vthinh-la/smart-solar-cloud-speaker-iot/docs/contest/LENH_DIEU_KHIEN_LOA_CLOUD.docx

Các lệnh MQTT điều khiển ESP32-Radio

1. Gửi lệnh MQTT

Lệnh điều khiển được publish vào topic:

prefix/command

Ví dụ:

mosquitto_pub -h broker.hivemq.com -t espradio/command -m "volume=80"

2. Các lệnh điều khiển

Lệnh | Chức năng
preset=12 | Chọn preset 12 để phát
preset_00=<mp3 stream> | Đặt preset 00 thành một URL stream
volume=95 | Đặt âm lượng ở mức 95%
upvolume=2 | Tăng âm lượng thêm 2%
downvolume=2 | Giảm âm lượng đi 2%
toneha=<0..15> | Điều chỉnh độ lớn của treble
tonehf=<0..15> | Điều chỉnh tần số treble
tonela=<0..15> | Điều chỉnh độ lớn của bass
tonelf=<0..15> | Điều chỉnh tần số bass
station=<mp3 stream> | Chuyển sang stream MP3 mới
station=<URL>.mp3 | Phát một file MP3 từ URL
station=<URL>.m3u | Phát một playlist M3U
mute | Bật tắt chế độ mute
unmute | Hủy chế độ mute
wifi_00=SSID/PASSWORD | Cài đặt WiFi
mqttbroker=mybroker.com | Đặt MQTT broker mới
mqttuser=myuser | Đặt tên người dùng MQTT
mqttpasswd=mypassword | Đặt mật khẩu MQTT
sleep | Đưa thiết bị vào chế độ ngủ sâu
status | Kiểm tra trạng thái hiện tại
debug=1 | Bật chế độ debug
reset | Khởi động lại ESP32

3. Các topic ESP32-Radio publish lên MQTT

Topic | Nội dung publish
prefix/ip | Địa chỉ IP của thiết bị
prefix/icy/name | Tên kênh radio đang phát
prefix/icy/streamtitle | Tiêu đề stream
prefix/nowplaying | Bài hát đang phát
prefix/preset | Preset hiện tại
prefix/volume | Mức âm lượng hiện tại
prefix/playing | 1 nếu đang phát, 0 nếu dừng
