vthinh-la/smart-solar-cloud-speaker-iot/docs/contest/Noi_Dung_San_Pham_Du_Thi.docx

Tên sản phẩm dự thi: Hệ Thống Loa Cloud IOT

1.Tại Sao EM chọn dự án này ?

Em chọn dự án “Hệ thống loa Cloud IoT” vì đây là một giải pháp tích hợp các công nghệ đơn giản nhưng hiệu quả để xây dựng một hệ thống loa phát thanh hoạt động độc lập. Hệ thống sử dụng mạng 4G để truyền tải âm thanh, giúp khắc phục những hạn chế của các hệ thống truyền thống như sóng FM hay hệ thống kéo dây, vốn yêu cầu hạ tầng phức tạp và dễ gặp phải các vấn đề về phạm vi phủ sóng hoặc thiệt hại do thời tiết. Việc tích hợp năng lượng mặt trời để sạc pin và pin lưu trữ giúp hệ thống duy trì hoạt động liên tục mà không cần nguồn điện lưới, điều này đặc biệt hữu ích ở các khu vực công cộng hoặc ngoài trời. Đặc biệt, hệ thống còn có cảm biến ánh sáng để tự động bật đèn khi trời tối, tăng cường tính tiện dụng và tiết kiệm năng lượng. Hệ thống có thể được triển khai tại các khu vực công cộng, như điểm trường, trạm y tế hay khu dân cư, giúp truyền tải thông tin một cách linh hoạt và hiệu quả mà không phụ thuộc vào các hạ tầng truyền thống.

Ứng Dụng Tại:

Khu vực công cộng: Hệ thống có thể được triển khai tại các điểm trường, trạm y tế, khu dân cư, hay các địa điểm công cộng khác để truyền tải thông tin, thông báo khẩn cấp hoặc tuyên truyền. Khả năng sử dụng mạng 4G và năng lượng mặt trời giúp hệ thống hoạt động độc lập, không phụ thuộc vào cơ sở hạ tầng điện và mạng lưới có sẵn.

Khu vực ngoài trời và vùng hẻo lánh: Với tính năng sử dụng năng lượng mặt trời và pin lưu trữ, hệ thống phù hợp cho các khu vực không có nguồn điện ổn định hoặc các khu vực không dễ dàng tiếp cận. Hệ thống này có thể sử dụng cho các trạm phát thanh ngoài trời, điểm du lịch hoặc khu vực nông thôn, nơi cần truyền tải thông tin mà không cần phải kéo dây điện hay sử dụng sóng FM truyền thống.

Hệ thống thông báo khẩn cấp: Trong các tình huống khẩn cấp như thiên tai hoặc thảm họa, hệ thống có thể được sử dụng để phát thông báo đến cộng đồng, nhờ khả năng hoạt động độc lập và truyền tải thông tin từ xa, ngay cả khi cơ sở hạ tầng khác không hoạt động.

Các sự kiện ngoài trời: Hệ thống có thể được dùng cho các sự kiện ngoài trời như lễ hội, hội thảo, hoặc các hoạt động cộng đồng, giúp phát thanh thông báo hoặc âm nhạc mà không cần quá nhiều thiết bị phức tạp.

Ứng dụng trong các công trình xây dựng: Hệ thống có thể được sử dụng trong các công trình xây dựng hoặc khu vực công nghiệp, giúp truyền tải thông tin nội bộ, cảnh báo hoặc hướng dẫn an toàn cho công nhân mà không phải kéo dây điện hoặc sử dụng các thiết bị truyền thống.

Cách Lắp Đặt:

1. Các khu vực công cộng

- Ví dụ ứng dụng:
  - Điểm trường học, trạm y tế, khu dân cư.
  - Công viên, quảng trường, khu vui chơi.
  - Các khu vực tổ chức sự kiện ngoài trời, như lễ hội, hội thảo cộng đồng.
- Cách lắp đặt:
  - Lắp đặt loa ở vị trí cao, dễ tiếp cận và có tầm phát sóng rộng, tránh vật cản như tòa nhà cao.
  - Tấm pin mặt trời được gắn lên mái nhà hoặc cột, nơi có ánh sáng mặt trời trực tiếp và không bị che khuất.
  - Đặt bộ sạc và pin lưu trữ ở khu vực kín đáo để bảo vệ khỏi mưa gió, nhưng vẫn đảm bảo thông gió.
  - Cảm biến ánh sáng được gắn tại nơi có thể phát hiện ánh sáng tự nhiên để điều khiển bật đèn khi trời tối.

2. Khu vực ngoài trời, nông thôn, miền núi

- Ví dụ ứng dụng:
  - Các thôn, bản chưa có điện hoặc hạ tầng mạng ổn định.
  - Trạm phát thanh thông tin cho cộng đồng tại khu vực nông thôn, nơi không có cơ sở hạ tầng mạng.
- Cách lắp đặt:
  - Chọn vị trí có tín hiệu 4G mạnh để đảm bảo kết nối ổn định (điều này rất quan trọng khi dùng 4G để truyền tải âm thanh).
  - Cột loa và tấm pin mặt trời có thể được dựng trên các cột hoặc mái nhà, cách xa các nguồn phát tín hiệu nhiễu (chẳng hạn như các khu vực nhiều tòa nhà hay cây cối).
  - Dây điện và kết nối: Dùng cáp dài để kết nối giữa các thiết bị trong hệ thống, đảm bảo an toàn và chịu được điều kiện thời tiết ngoài trời.

3. Hệ thống thông báo khẩn cấp

- Ví dụ ứng dụng:
  - Các khu vực dễ bị thiên tai như vùng ven biển, khu vực dễ xảy ra động đất, cháy nổ.
- Cách lắp đặt:
  - Lắp đặt ở các khu vực dễ bị tác động: Chẳng hạn như trạm cứu hộ, tòa nhà công cộng, khu vực cư trú gần khu vực nguy hiểm.
  - Dùng pin và tấm pin mặt trời để hệ thống hoạt động liên tục mà không cần nguồn điện chính.
  - Tạo mạng lưới kết nối các loa để có thể phát âm thanh đồng bộ, truyền tải thông báo khẩn cấp trong thời gian thực.

4. Các công trình xây dựng

- Ví dụ ứng dụng:
  - Các công trường xây dựng, khu vực thi công hoặc các khu công nghiệp.
- Cách lắp đặt:
  - Đặt loa ở các khu vực dễ nghe: Chọn vị trí lắp đặt loa sao cho âm thanh được phát tán rộng rãi đến các khu vực thi công hoặc xung quanh công trường.
  - Đặt tấm pin mặt trời trên các giàn giáo hoặc mái công trình để dễ dàng tiếp xúc với ánh sáng mặt trời.
  - Hệ thống hoạt động bằng pin và năng lượng mặt trời giúp công nhân nhận được thông tin cảnh báo hoặc thông báo về an toàn lao động.

Hệ thống loa Cloud IoT chủ yếu sẽ được sử dụng bởi các đối tượng sau:

1. Chính quyền địa phương và các cơ quan công cộng

- Ứng dụng: Truyền tải thông tin, thông báo khẩn cấp, tuyên truyền, thông báo về các chính sách, sự kiện hoặc thông tin cộng đồng đến người dân trong các khu vực công cộng như trường học, trạm y tế, khu dân cư.
- Lý do sử dụng: Các cơ quan này cần hệ thống có thể hoạt động độc lập, tiết kiệm chi phí và không phụ thuộc vào hạ tầng mạng lưới điện hay Wi-Fi, đặc biệt là ở các khu vực hẻo lánh hoặc thiếu cơ sở hạ tầng truyền thống.

2. Các tổ chức, doanh nghiệp hoạt động ngoài trời

- Ứng dụng: Các tổ chức, doanh nghiệp tổ chức sự kiện ngoài trời, như lễ hội, hội thảo cộng đồng, sự kiện thể thao, hoặc các hoạt động quảng bá ngoài trời.
- Lý do sử dụng: Hệ thống loa Cloud IoT có thể dễ dàng triển khai mà không cần kéo dây điện hay có sự phụ thuộc vào cơ sở hạ tầng truyền thông cố định. Điều này rất hữu ích trong các sự kiện quy mô lớn hoặc ở các địa điểm không có nguồn điện lưới.

3. Các khu vực dân cư nông thôn và miền núi

- Ứng dụng: Hệ thống có thể được sử dụng để phát thanh thông tin đến các khu vực nông thôn, miền núi, hoặc các cộng đồng chưa có đầy đủ cơ sở hạ tầng truyền thông và điện lưới.
- Lý do sử dụng: Với khả năng sử dụng 4G và năng lượng mặt trời, hệ thống có thể hoạt động độc lập mà không cần phụ thuộc vào điện lưới, rất phù hợp cho các khu vực hẻo lánh nơi không có hạ tầng mạng ổn định.

4. Các đơn vị cứu hộ và cứu nạn

- Ứng dụng: Sử dụng hệ thống loa để phát thông báo khẩn cấp, cảnh báo về thiên tai, tình trạng khẩn cấp trong các khu vực dễ bị ảnh hưởng như vùng bão, vùng có động đất.
- Lý do sử dụng: Hệ thống có khả năng duy trì hoạt động liên tục nhờ pin lưu trữ và năng lượng mặt trời, giúp truyền tải thông tin khi có sự cố mà không bị gián đoạn, ngay cả khi nguồn điện lưới không khả dụng.

5. Các khu công nghiệp và công trình xây dựng

- Ứng dụng: Phát thông báo về an toàn lao động, hướng dẫn, hoặc cảnh báo đến công nhân làm việc tại các công trường xây dựng hoặc khu công nghiệp.
- Lý do sử dụng: Hệ thống loa có thể phát âm thanh đồng bộ đến nhiều khu vực trong công trình mà không cần phải kéo dây điện, giúp thông báo hiệu quả trong môi trường có nhiều hoạt động và không gian rộng lớn.

Ưu Điểm:

Hệ thống loa Cloud IoT: Hoạt động độc lập nhờ vào năng lượng mặt trời và pin lưu trữ, giúp có thể sử dụng ở các khu vực không có nguồn điện lưới ổn định.

Hệ thống loa Cloud IoT: Sử dụng mạng 4G để truyền tải âm thanh, có thể điều khiển từ xa qua đám mây, giúp dễ dàng quản lý và giám sát hệ thống mà không cần phải có mặt trực tiếp.

Hệ thống loa Cloud IoT: Có thể dễ dàng mở rộng và kết nối nhiều loa cùng lúc mà không cần phải kéo dây, phù hợp cho các sự kiện hoặc khu vực rộng lớn.

Hệ thống loa Cloud IoT: Hệ thống có thể tự động bật đèn khi trời tối nhờ cảm biến ánh sáng, giúp tiết kiệm năng lượng và tăng hiệu quả hoạt động.

Hệ thống loa Cloud IoT: Dễ dàng triển khai ở bất kỳ đâu có tín hiệu mạng 4G và có thể lắp đặt ngoài trời mà không cần kết nối phức tạp. Không cần phải kéo dây điện hay hệ thống mạng phức tạp.

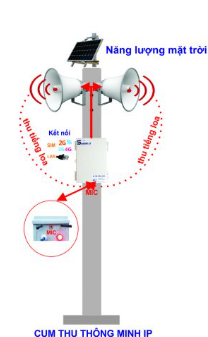
[picture p39: figure]

Bộ Phát

MIC → Laptop → Máy Chủ → Modem Mạng → Internet

Bộ Thu

Internet → Modem 4G → Bộ Giải Mã, Khuếch Đại → Loa Nén
