vthinh-la/smart-solar-cloud-speaker-iot/(notices)

Notices in the files:
README.md:
License: Apache 2.0
